doublehan07/MM-Radio/docs/images/toys.jpg

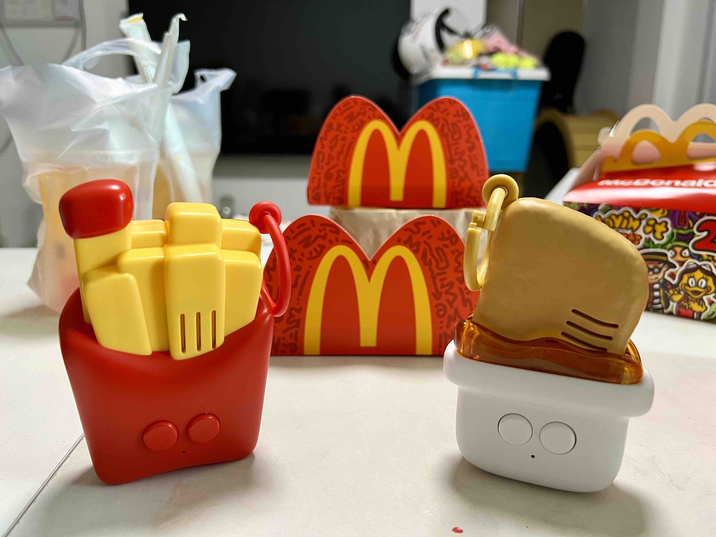
docs/images/toys.jpg
