doublehan07/MM-Radio/docs/mm-circuit.pdf

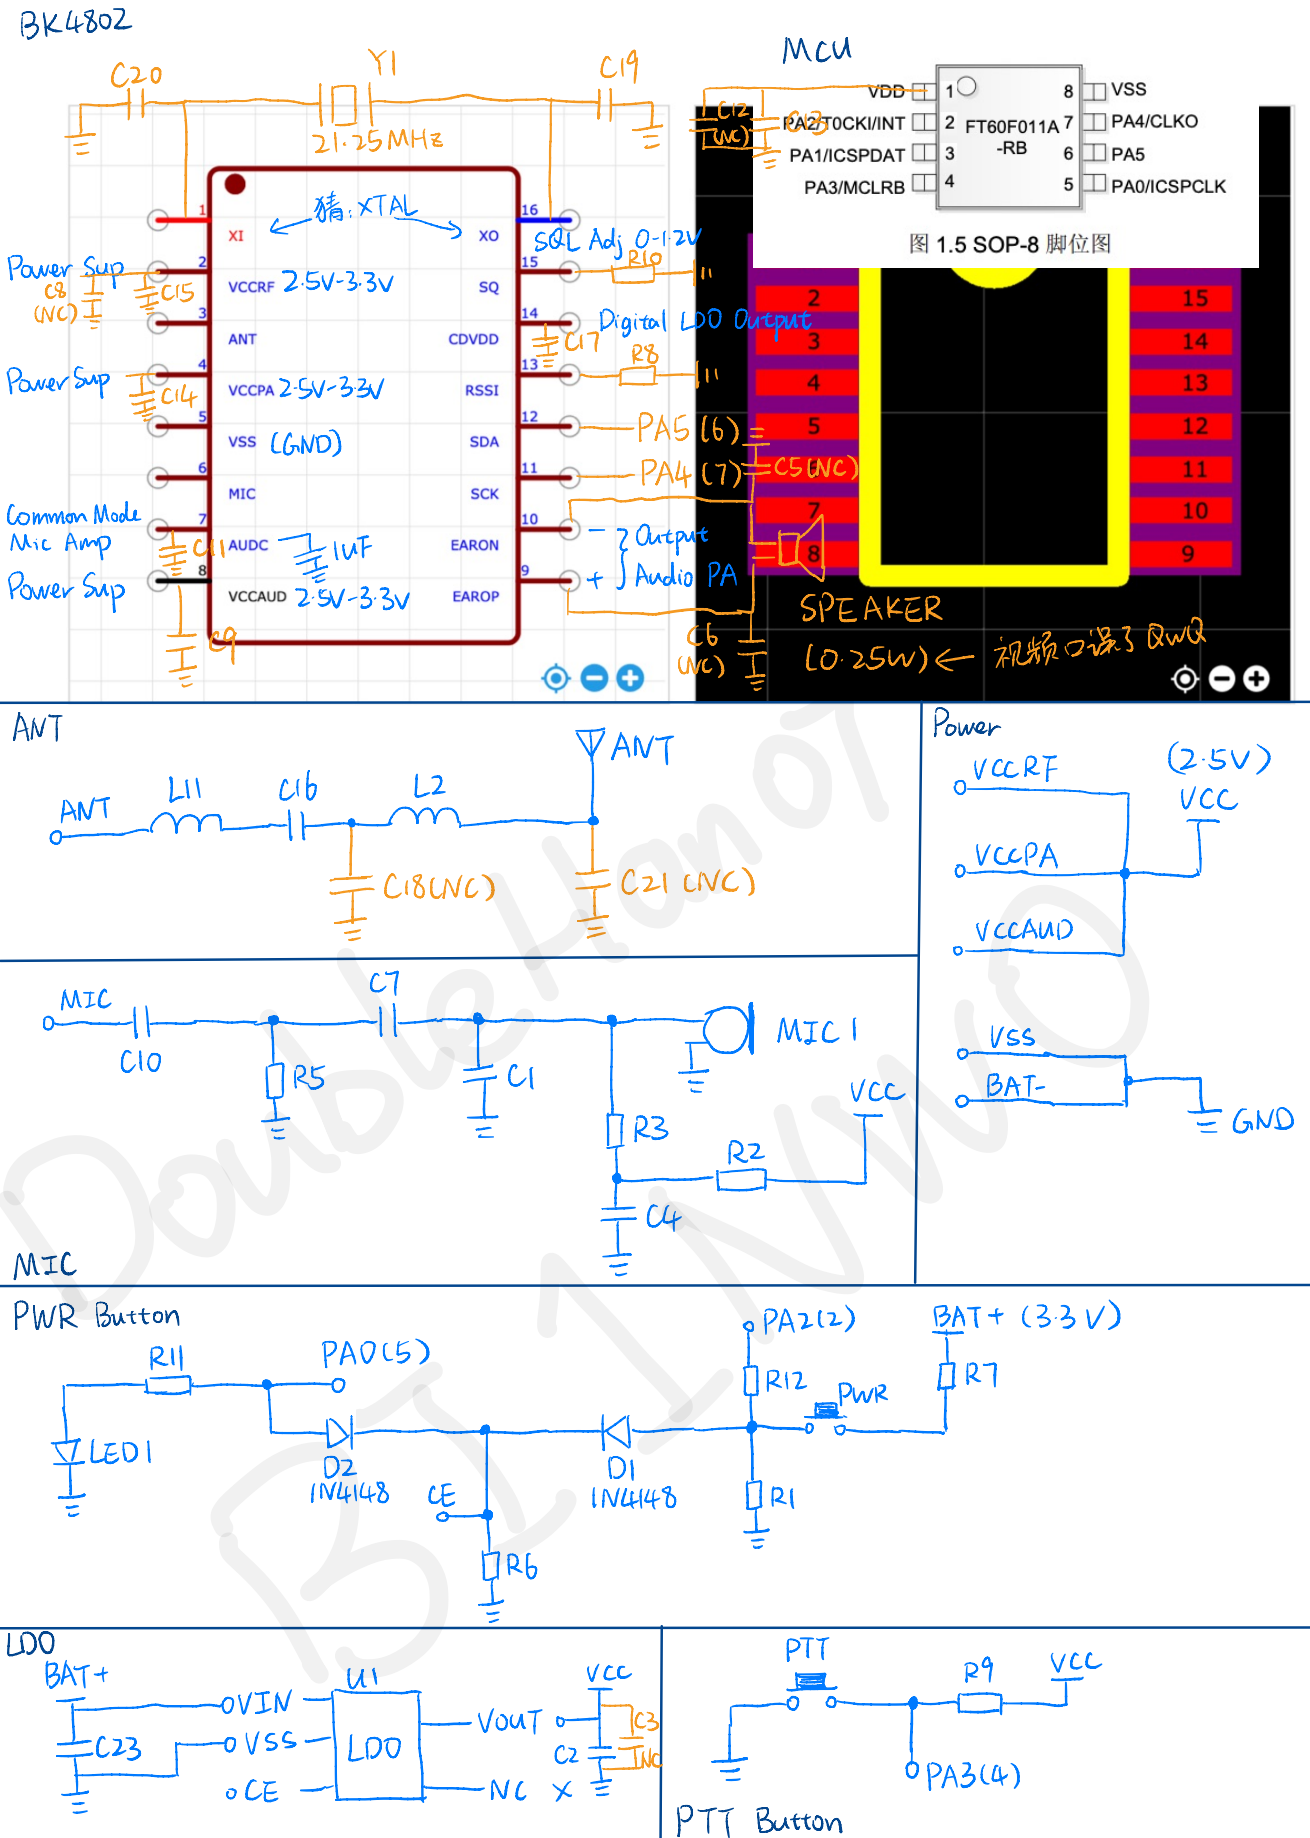
[picture p20: page 1]
