doublehan07/MM-Radio/Users/delay.h

/*
	@Copyright Han ZHANG (DoubleHan) | All rights reserved.
	@Last Modified Time Apr.29, 2023
*/

/* Define to prevent recursive inclusion -------------------------------------*/
#ifndef __sDELAY_H
#define __sDELAY_H

/* Includes ------------------------------------------------------------------*/
#include "main.h"

/* Exported types ------------------------------------------------------------*/
/* Exported constants --------------------------------------------------------*/
/* Exported macro ------------------------------------------------------------*/
/* Exported functions ------------------------------------------------------- */
void DBH_DecTick(void);
void DBH_DelayMS(uint32_t delay_time_ms);

#endif /* __sDELAY_H */
